HackHype/AlimLigne_PassionIIm/BOM_LignePassionIIm.xlsx

BOM - PCB Bloc de Ligne Passion IIM
Quoi | Variante | Ref PCB | Valeur | Reference | Qty/PCB | Qty/Tot | Prix | PrixTot/PCB | Fabriquant | Fournisseur | Lien | Etat
Borne a Vis |  | J1, J2, J4 | P2.54mm |  | 3 |  |  | 0.00 CHF |  | AliExpress
Borne a Vis |  | J3 | P5.08mm |  | 1 |  |  | 0.00 CHF |  | AliExpress
Resistance Gate FET |  | R14 | 100R 5W |  | 1 |  | 0.15 CHF | 0.15 CHF |  | AliExpress | https://de.aliexpress.com/item/1005005674103930.html
Resistance de Shunt |  | R3 | 1R 2W |  | 1 |  | 0.08 CHF | 0.08 CHF |  | AliExpress | https://de.aliexpress.com/item/1005004002774546.html
Fiche Banane Rouge | Ligne |  |  |  | 1 |  | 0.05 CHF | 0.05 CHF |  | AliExpress | https://de.aliexpress.com/item/1005011562556892.html
Fiche Banane Noir | Ligne |  |  |  | 1 |  | 0.05 CHF | 0.05 CHF |  | AliExpress | https://de.aliexpress.com/item/1005011562556892.html
Fiche Banane Bleu | Ligne |  |  |  | 1 |  | 0.05 CHF | 0.05 CHF |  | AliExpress | https://de.aliexpress.com/item/1005011562556892.html
Fiche Banane Jaune | Ligne |  |  |  | 1 |  | 0.05 CHF | 0.05 CHF |  | AliExpress | https://de.aliexpress.com/item/1005011562556892.html
Interrupteur | Ligne |  | 3 pos 3 cont |  | 1 |  | 1.52 CHF | 1.52 CHF |  | AliExpress | https://de.aliexpress.com/item/1005012410174447.html
Bouton poussoir |  |  |  |  | 2 |  | 0.43 CHF | 0.86 CHF |  | AliExpress | https://de.aliexpress.com/item/1005008777027854.html
Led |  |  | vertes |  | 2 |  | 0.05 CHF | 0.10 CHF |  | AliExpress
Led |  |  | jaunes |  | 2 |  | 0.05 CHF | 0.10 CHF |  | AliExpress
Dissipateur termique |  |  |  |  | 1 |  | 0.15 CHF | 0.15 CHF |  | AliExpress | https://de.aliexpress.com/item/32676786935.html
Relai BiStable de Puissance | Toutes | K1 |  | 41.52.6.012.4016 | 1 |  | 5.50 CHF | 5.50 CHF | Finder | Conrad | https://www.conrad.ch/fr/p/finder-41-52-6-012-4016-relais-pour-circuits-imprimes-12-v-dc-8-a-2-inverseurs-rt-1-pc-s-1419696.html
Transistor |  | Q1 |  | IRFU5305PBF | 1 |  | 0.42 CHF | 0.42 CHF | Infineon Technologie | Conrad | https://www.conrad.ch/fr/p/infineon-technologies-irfu5305pbf-mosfet-1-canal-p-110-w-i-pak-162729.html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
Connecteur DIN |  |  |  |  | 2 |  | 2.45 CHF | 4.90 CHF |  | Conrad | https://www.conrad.ch/de/p/tru-components-tc-13895648-rundsteckverbinder-stecker-buchsenkontakt-gesamtpolzahl-6-serie-rundsteckverbinder-gx16-3473912.html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
Potentiometre |  |  | 4K7 |  | 1 |  | 4.25 CHF | 4.25 CHF |  | Conrad | https://www.conrad.ch/fr/p/potentiometre-rotatif-weltron-wcip20cips-08-60f1-4k7-20-lin-002045038962-avec-interrupteur-mono-0-4-w-4-7-k-1-pc-s-441128.html
555 | Toutes | U1 |  | TLC555CP | 1 |  | 0.68 CHF | 0.68 CHF | TI | Digikey | https://www.digikey.ch/fr/products/detail/texas-instruments/TLC555CP/277502 | Commandé
Transistor | Toutes | Q2, Q3, Q4 |  | 2N2222A | 3 |  | 0.09 CHF | 0.26 CHF | Diotec Semiconductor | Digikey | https://www.digikey.ch/fr/products/detail/diotec-semiconductor/2N2222A/13164037 | Commandé
Mosfet | Toutes | Q6 |  | IRF4905PBF | 1 |  | 2.48 CHF | 2.48 CHF | Infineon Technologie | Digikey | https://www.digikey.ch/fr/products/detail/infineon-technologies/IRF4905PBF/812139 | Commandé
Diode Roue Libr Mosfet | Toutes | D5 |  | MUR420G | 1 |  | 0.51 CHF | 0.51 CHF | Onsemi | Digikey | https://www.digikey.ch/fr/products/detail/onsemi/MUR420G/1482828?s=N4IgTCBcDaILIFUBKAWMAGA4iAugXyA | Commandé
Diode | 2 Arduino 4 Autres | D1, D2, D3, D4 |  | 1N4007 | 4 |  | 0.07 CHF | 0.27 CHF | Diotec Semiconductor | Digikey | https://www.digikey.ch/fr/products/detail/diotec-semiconductor/1N4007/18833652 | Commandé
Diode Zener | Toutes | D6 |  | 1N4733A | 1 |  | 0.23 CHF | 0.23 CHF |  | Digikey | https://www.digikey.ch/fr/products/detail/onsemi/1n4733a/977210 | Commandé
Capuchon pour pot |  |  |  |  | 1 |  | 1.00 CHF | 1.00 CHF |  | Impression 3D
Relai Bistable de Signal | Toutes | K2 |  |  | 1 |  | 0.50 CHF | 0.50 CHF |  | Stock
Condensateur |  | C3 | 100nF |  | 1 |  | 0.05 CHF | 0.05 CHF |  | Stock
Condensateur |  | C4 | 1nF |  | 1 |  | 0.05 CHF | 0.05 CHF |  | Stock
Resistance |  | R8, R10, R13, R14, R19 | 10K |  | 5 |  | 0.05 CHF | 0.25 CHF |  | Stock
Resistance |  | R4, R12, R15 | 1K 1/4W |  | 3 |  | 0.05 CHF | 0.15 CHF |  | Stock
Resistance |  | R7 | 470R 1/4W |  | 1 |  | 0.05 CHF | 0.05 CHF |  | Stock
Resistance |  | R9, R18 | 270R 1/4W |  | 2 |  | 0.05 CHF | 0.10 CHF |  | Stock
Resistance |  | R1, R2, R5, R6 | Pour led |  | 4 |  | 0.05 CHF | 0.20 CHF |  | Stock
Condensateur |  | C1, C2 | ~1000uF |  | 2 |  |  | 0.00 CHF
Condensateur |  | C5 | 270nF |  | 1 |  |  | 0.00 CHF
Date : |  | 2026-04-14 | #VALUE!
Auteur : |  | Jules Grucy
Revision : |  | V2
Approbateur : |  | Damien De P.
