HackHype/AlimLigne_PassionIIm/Repartition_couts.xlsx

Sheet: Offre
 | Pupitre ligne | Régulateur traction | Matériel réserve | Prototype | Sous-total | Total
 | 45 | 35 | 35 | 45
Commun |  |  |  | 1 | 45.00 CHF
Fred | 2 | 4 | 1 |  | 265.00 CHF | 280.00 CHF
Stéphane | 2 | 1 | 1 |  | 160.00 CHF | 175.00 CHF
Raphael | 1 | 1 | 1 |  | 115.00 CHF | 130.00 CHF
 |  |  |  |  |  | 585.00 CHF

Sheet: Compte
Depenses
Digikey | 77.35 CHF
Aliexpress | 100.61 CHF
Conrad 1
Conrad (est) | 230.00 CHF
stock (est) | 21.00 CHF
PCB (est) | 43.00 CHF
3D (est) | 66.00 CHF
Total | 537.96 CHF
Marge (est) | 47.04 CHF
