HackHype/AlimLigne_PassionIIm/Meca_IIm_Ligne/StandardParts/contrainte.pdf

## Module « Bureau technique » - CAO mécanique

### 1. Contraintes disponibles dans Inventor

Icônes | Contrainte | Description
| Horizontale | Permet de fixer une distance horizontale entre 2 points.
| Verticale | Permet de fixer une distance verticale entre 2 points.
| Perpendiculaire | Contraint 2 lignes à être perpendiculaires l'une par rapport à l'autre.
| Parallèle | Contraint 2 lignes à être parallèles l'une par rapport à l'autre.
| Tangente | Contraint 2 courbes à un point de tangence.
| Symétrique | Force 2 objets à se placer symétriquement l'un par rapport à l'autre.
| Fixe | Permet de fixer un point ou un objet à un emplacement dans le dessin.
| Egal | Force 2 lignes à avoir une longueur identique ou 2 arcs ou cercles au même rayon.
| Concentrique | Permet de placer 2 cercles ou arcs sur le même centre.
| Doux | Permet de contraindre une spline à se positionner dans la continuité d'un objet.
| Colinéaire | Permet de contraindre 2 lignes sur le même axe l'une par rapport à l'autre.
| Coïncidence | Permet de faire coïncider un point par rapport à un autre point ou objet.

## Module « Bureau technique » - CAO mécanique

### 1. Contraintes disponibles dans Inventor

Icônes | Contrainte | Description
| Horizontale | Permet de fixer une distance horizontale entre 2 points.
| Verticale | Permet de fixer une distance verticale entre 2 points.
| Perpendiculaire | Contraint 2 lignes à être perpendiculaires l'une par rapport à l'autre.
| Parallèle | Contraint 2 lignes à être parallèles l'une par rapport à l'autre.
| Tangente | Contraint 2 courbes à un point de tangence.
| Symétrique | Force 2 objets à se placer symétriquement l'un par rapport à l'autre.
| Fixe | Permet de fixer un point ou un objet à un emplacement dans le dessin.
| Egal | Force 2 lignes à avoir une longueur identique ou 2 arcs ou cercles au même rayon.
| Concentrique | Permet de placer 2 cercles ou arcs sur le même centre.
| Doux | Permet de contraindre une spline à se positionner dans la continuité d'un objet.
| Colinéaire | Permet de contraindre 2 lignes sur le même axe l'une par rapport à l'autre.
| Coïncidence | Permet de faire coïncider un point par rapport à un autre point ou objet.
