HackHype/AlimLigne_PassionIIm/3D/to92-7.snapshot.5/TO92.STEP

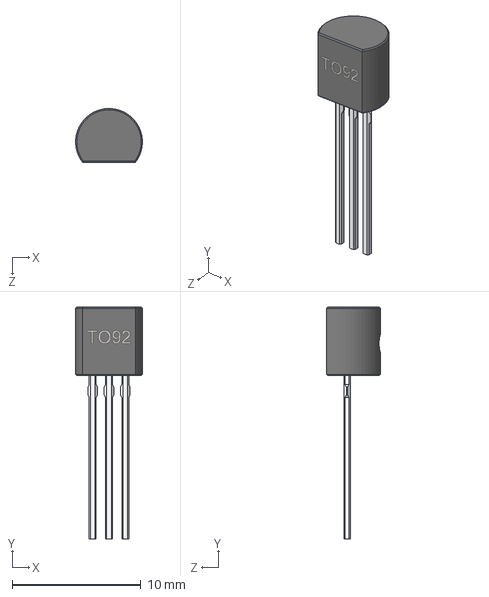
[picture p1: CAD file, 2026-05-08]
3D/to92-7.snapshot.5/TO92.STEP
5.20 x 18.0 x 4.20 mm
