HackHype/AlimLigne_PassionIIm/3D/to92-7.snapshot.5/TO92_2.STEP

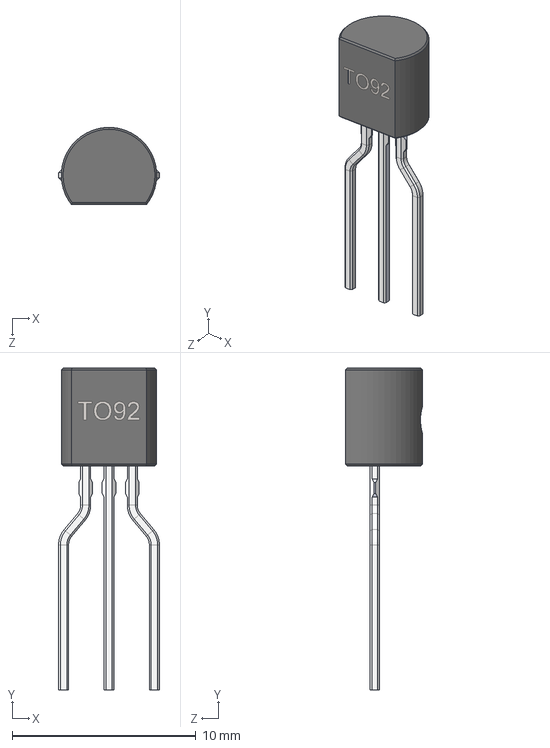
[picture p3: CAD file, 2026-05-08]
3D/to92-7.snapshot.5/TO92_2.STEP
5.49 x 17.5 x 4.20 mm
