HackHype/AlimLigne_PassionIIm/Meca_IIm_Ligne/Couvercle_Meca_IIm_Ligne.obj

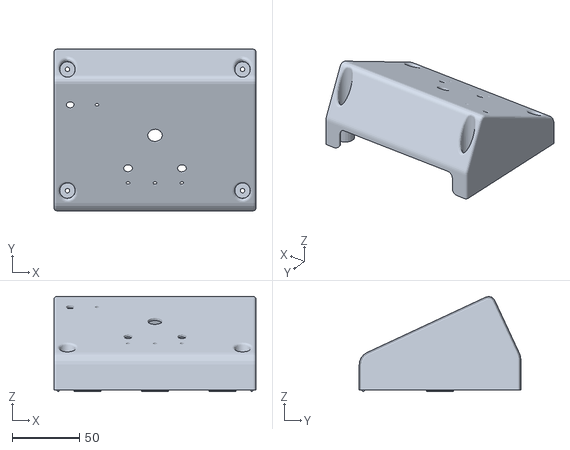
[picture p4: CAD file, 2026-09-28]
Meca_IIm_Ligne/Couvercle_Meca_IIm_Ligne.obj
150.0 x 120.0 x 70.6
