HackHype/AlimLigne_PassionIIm/Meca_IIm_Ligne/Leste_Meca_IIm_Ligne.obj

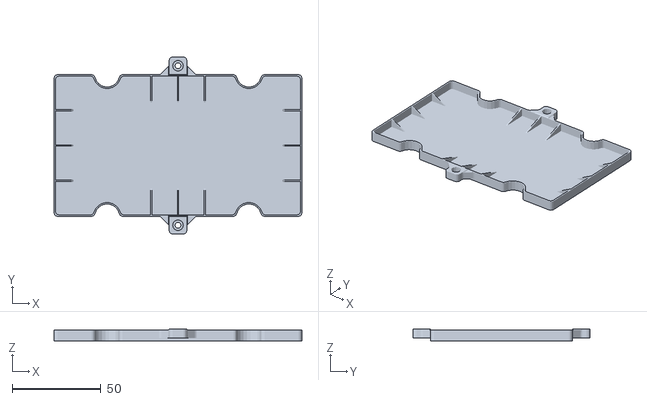
[picture p5: CAD file, 2026-09-06]
Meca_IIm_Ligne/Leste_Meca_IIm_Ligne.obj
140.0 x 100.0 x 6.50
