HackHype/AlimLigne_PassionIIm/(list of files, cad)

Other CAD files:
3D/to92-7.snapshot.5/TO92.x_t
3D/to92-7.snapshot.5/TO92_2.x_t
Meca_IIm_Ligne/Base_Meca_IIm_Ligne.ipt
Meca_IIm_Ligne/Couvercle_Meca_IIm_Ligne.ipt
Meca_IIm_Ligne/E1_Base_Meca_IIm_Ligne.iam
Meca_IIm_Ligne/Leste_Meca_IIm_Ligne.ipt
Meca_IIm_Ligne/OldVersions/Base_Meca_IIm_Ligne.0007.ipt
Meca_IIm_Ligne/OldVersions/Couvercle_Meca_IIm_Ligne.0010.ipt
Meca_IIm_Ligne/OldVersions/E1_Base_Meca_IIm_Ligne.0008.iam
Meca_IIm_Ligne/OldVersions/Leste_Meca_IIm_Ligne.0005.ipt
Meca_IIm_Ligne/StandardParts/Etau/P2305_004_Vis.ipt
Meca_IIm_Ligne/StandardParts/Etau/P2305_005_Ecrou.ipt
Meca_IIm_Ligne/StandardParts/Item/Item_0037001_Ecrou_M5.ipt
Meca_IIm_Ligne/StandardParts/Item/Item_0037006_Ecrou_M4.ipt
Meca_IIm_Ligne/StandardParts/Item/Item_0043719_Ecrou_M3.ipt
Meca_IIm_Ligne/StandardParts/Item/item_0037003_Profil_5_20x20.ipt
Meca_IIm_Ligne/StandardParts/Visserie/BN1075_RondellePolyamide.ipt
Meca_IIm_Ligne/StandardParts/Visserie/BN1976_RondelleAjustage.ipt
Meca_IIm_Ligne/StandardParts/Visserie/BN425_GoujonFilete.ipt
Meca_IIm_Ligne/StandardParts/Visserie/BN5281_DouilleEcartement.ipt
Meca_IIm_Ligne/StandardParts/Visserie/BN7372_EntretoiseHexagonale.ipt
Meca_IIm_Ligne/StandardParts/Visserie/ISO14581.ipt
Meca_IIm_Ligne/StandardParts/Visserie/ISO4032_Ecrou.ipt
Meca_IIm_Ligne/StandardParts/Visserie/ISO4032_Ecrou/ISO4032_M3.ipt
Meca_IIm_Ligne/StandardParts/Visserie/ISO4762.ipt
Meca_IIm_Ligne/StandardParts/Visserie/ISO4762/ISO4762_M3x10.ipt
Meca_IIm_Ligne/StandardParts/Visserie/ISO4762/ISO4762_M3x5.ipt
Meca_IIm_Ligne/StandardParts/Visserie/ISO7089_Rondelle.ipt
Meca_IIm_Ligne/StandardParts/Visserie/SN213912.ipt
