HackHype/AlimLigne_PassionIIm/Meca_IIm_Ligne/StandardParts/Scotch/P1305_001_Axe.pdf

28

(4) 20

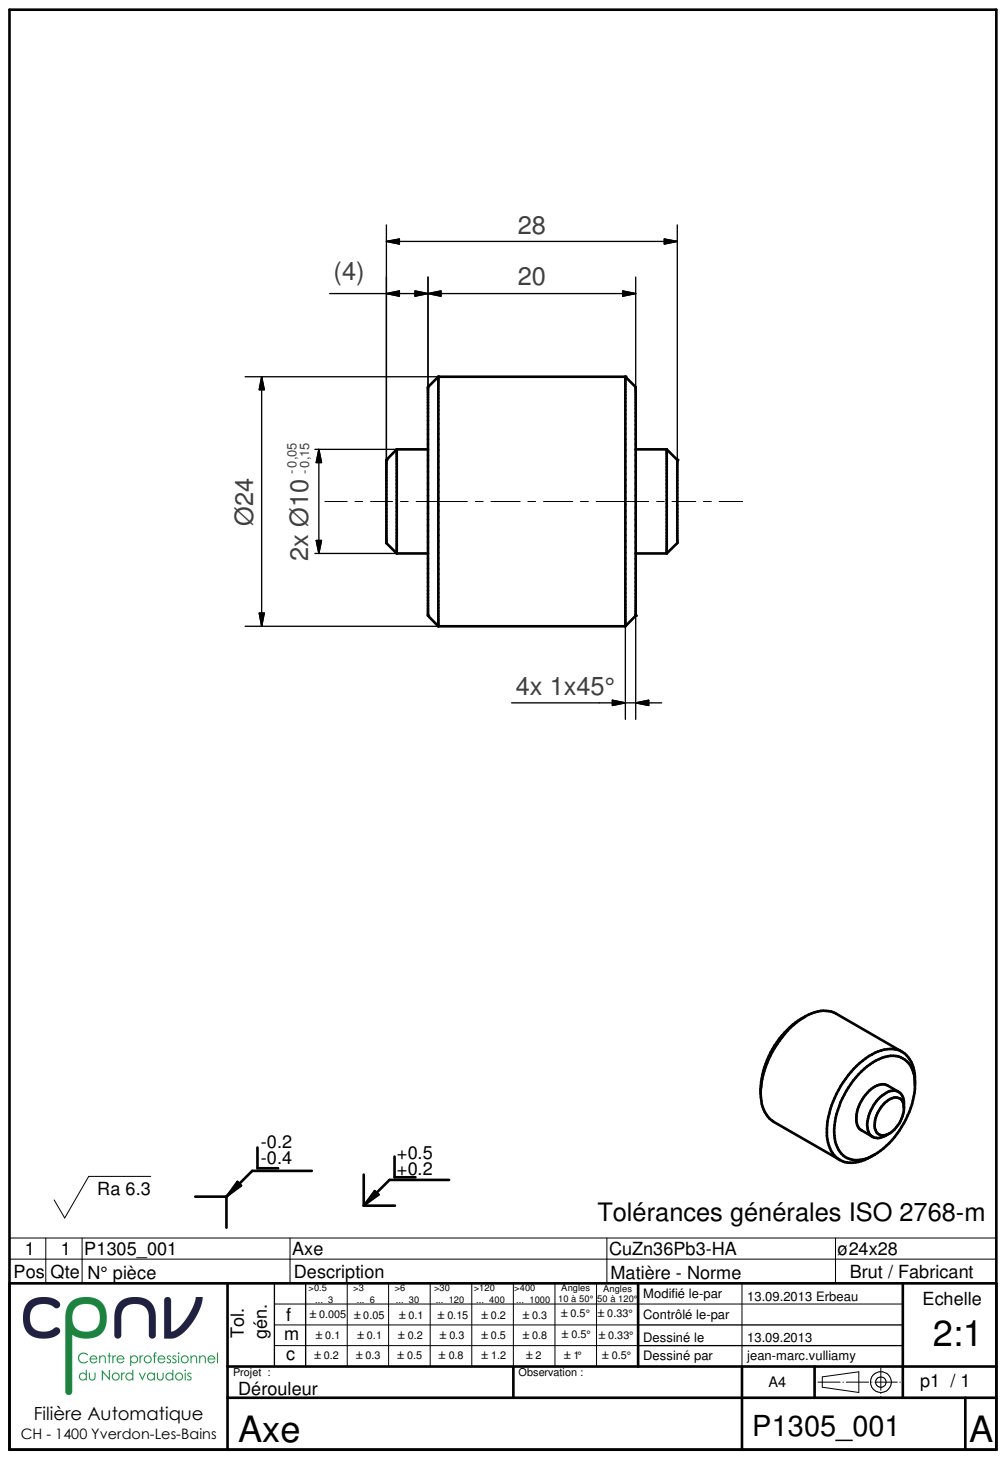
[picture p6: page 1]
gén.

Tolérances générales ISO 2768-m

1 | 1 | P1305_001 | Axe | CuZn36Pb3-HA | ø24x28
Pos | Qte | N° pièce | Description | Matière - Norme | Brut / Fabricant

Filière Automatique CH - 1400 Yverdon-Les-Bains | | | >0.5 ... 3 | >3 ... 6 | >6 ... 30 | >30 ... 120 | >120 ... 400 | >400 ... 1000 | Angles 10 à 50° | Angles 50 à 120° | Modifié le-par | 13.09.2013 Erbeau | Echelle 2:1

f | `0.005 | `0.05 | `0.1 | `0.15 | `0.2 | `0.3 | `0.5° | `0.33° | Contrôlé le-par
m | `0.1 | `0.1 | `0.2 | `0.3 | `0.5 | `0.8 | `0.5° | `0.33° | Dessiné le | 13.09.2013

c | `0.2 | `0.3 | `0.5 | `0.8 | `1.2 | `2 | `1° | `0.5° | Dessiné par | jean-marc.vulliamy

Projet : Dérouleur | Observation : | A4 | | | | p1 / 1
Axe | P1305_001 | A
