HackHype/AlimLigne_PassionIIm/Meca_IIm_Ligne/StandardParts/Scotch/P1305_004_couteau.pdf

A-A ( 2 : 1 ) | B ( 4 : 1 ) | C ( 2 : 1 )

2x 6

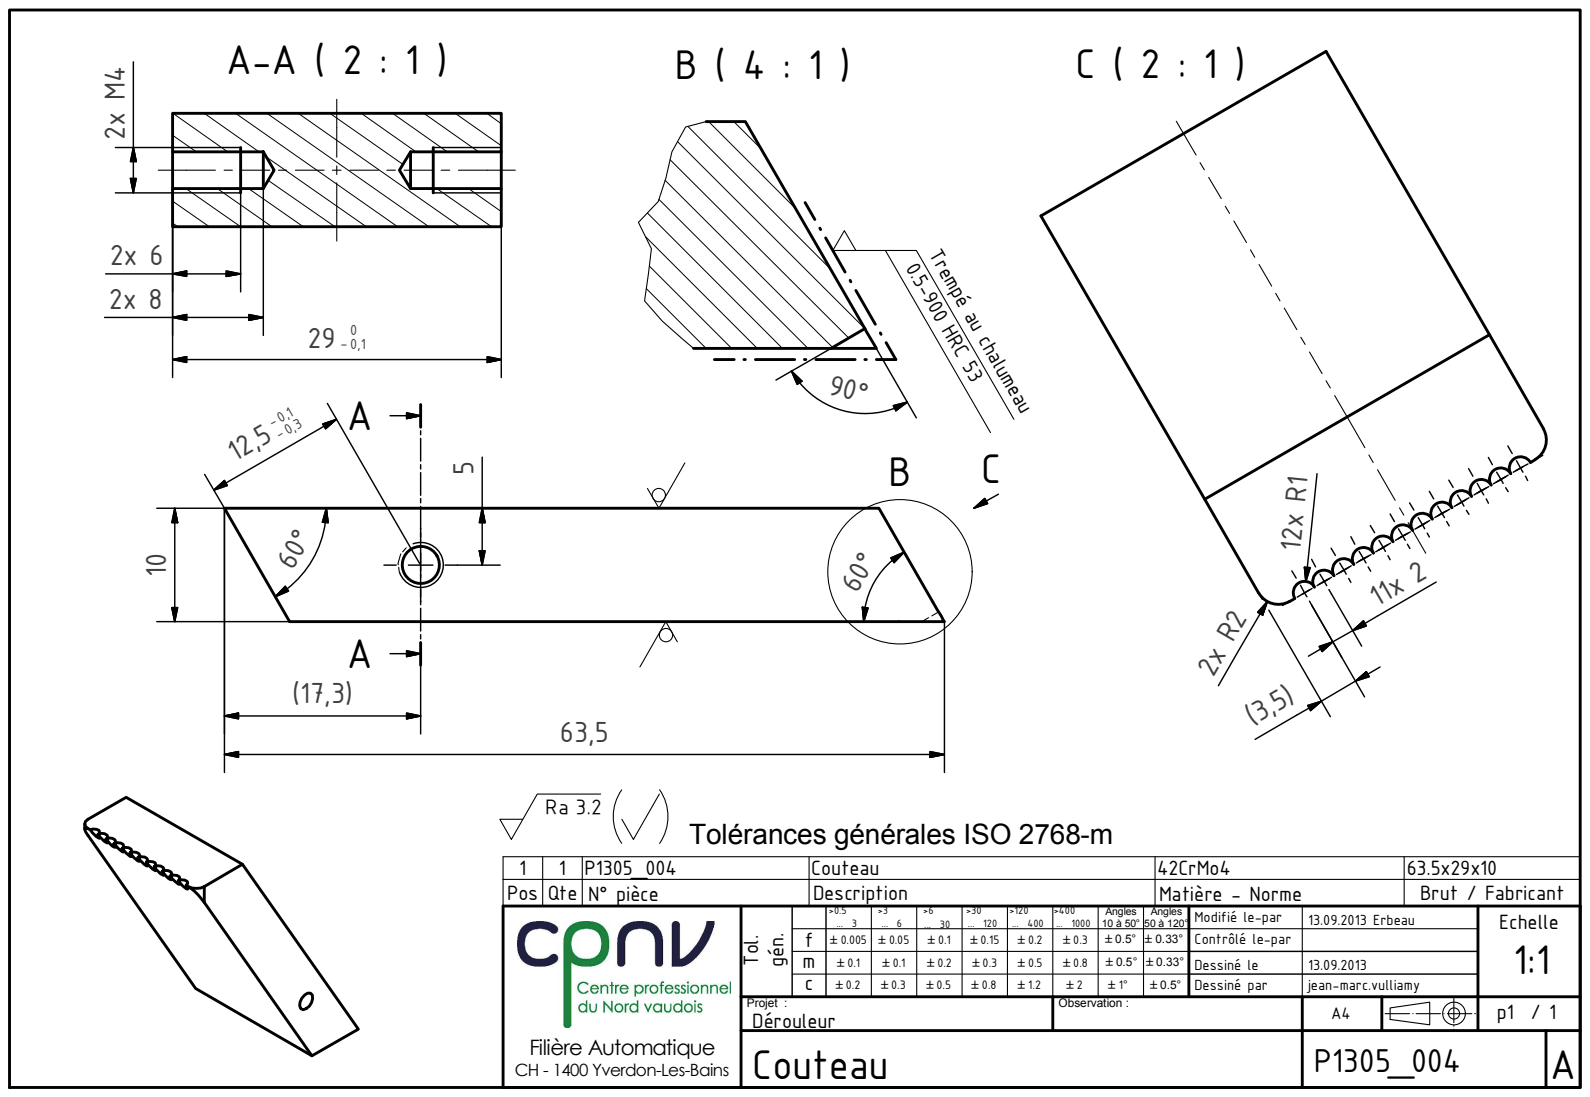
[picture p7: page 1]
Couteau; 42CrMo4; Pos; Qte; Description; Matire - Norme; Brut / Fabricant; Tol.; Angles; Echelle; Dessin par; Observation :; Drouleur; Projet :; Modifi le-par; 13.09.2013 Erbeau; Angles 10 j 50°; Tremp; au chalumeau; HRC

Tolprances gpnprales ISO 2768-m

f | B0.005 | B0.05 | B0.1 | B0.15 | B0.2 | B0.3 | B0.5° | B0.33° | Contr§l le-par

m | B0.1 | B0.1 | B0.2 | B0.3 | B0.5 | B0.8 | B0.5° | B0.33° | Dessin le

jean-marc.vulliamy

Filiqre Automatique
CH - 1400 Yverdon-Les-Bains
