HackHype/AlimLigne_PassionIIm/Meca_IIm_Ligne/StandardParts/Scotch/P1305_EG_Derouleur.pdf

5 | 1 | 2

3

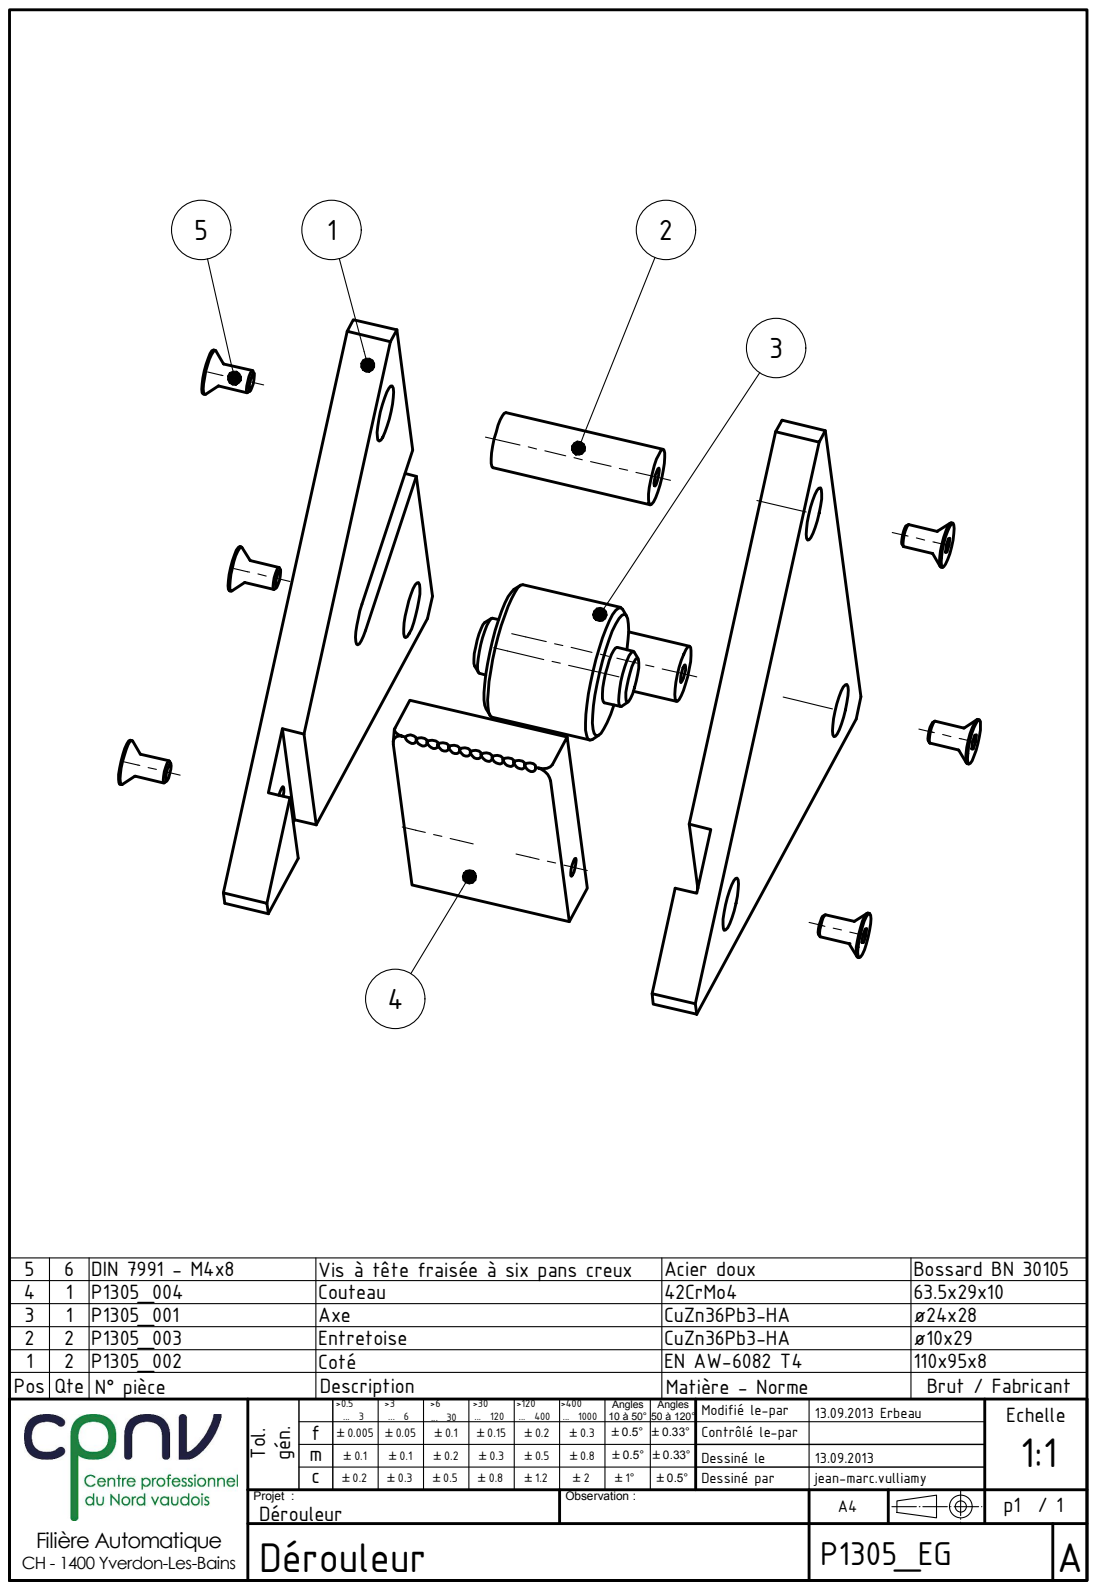
[picture p8: page 1]
DIN 7991 - M4x8; Vis  tte fraise  six pans creux; Acier doux; Bossard BN 30105; Couteau; 42CrMo4; Axe; CuZn36Pb3-HA; Entretoise; Cot; Pos; Qte; Description; Matire - Norme; Brut / Fabricant; Tol.; Angles; Echelle; Dessin par; Observation :; Drouleur; Projet :; Modifi le-par; 13.09.2013 Erbeau; Angles 10 j 50°

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

jean-marc.vulliamy

Filiqre Automatique
CH - 1400 Yverdon-Les-Bains
