HackHype/AlimLigne_PassionIIm/555.asc

D1: diode
D2: diode
R1: res
R2: res
U1: NE555
V1: voltage
Named nets: 0, V_CC
