HackHype/AlimLigne_PassionIIm/PCB_IIm_Ligne.kicad_sch

## KiCad design PCB_IIm_Ligne.kicad_sch (2026-10-16, an earlier design)

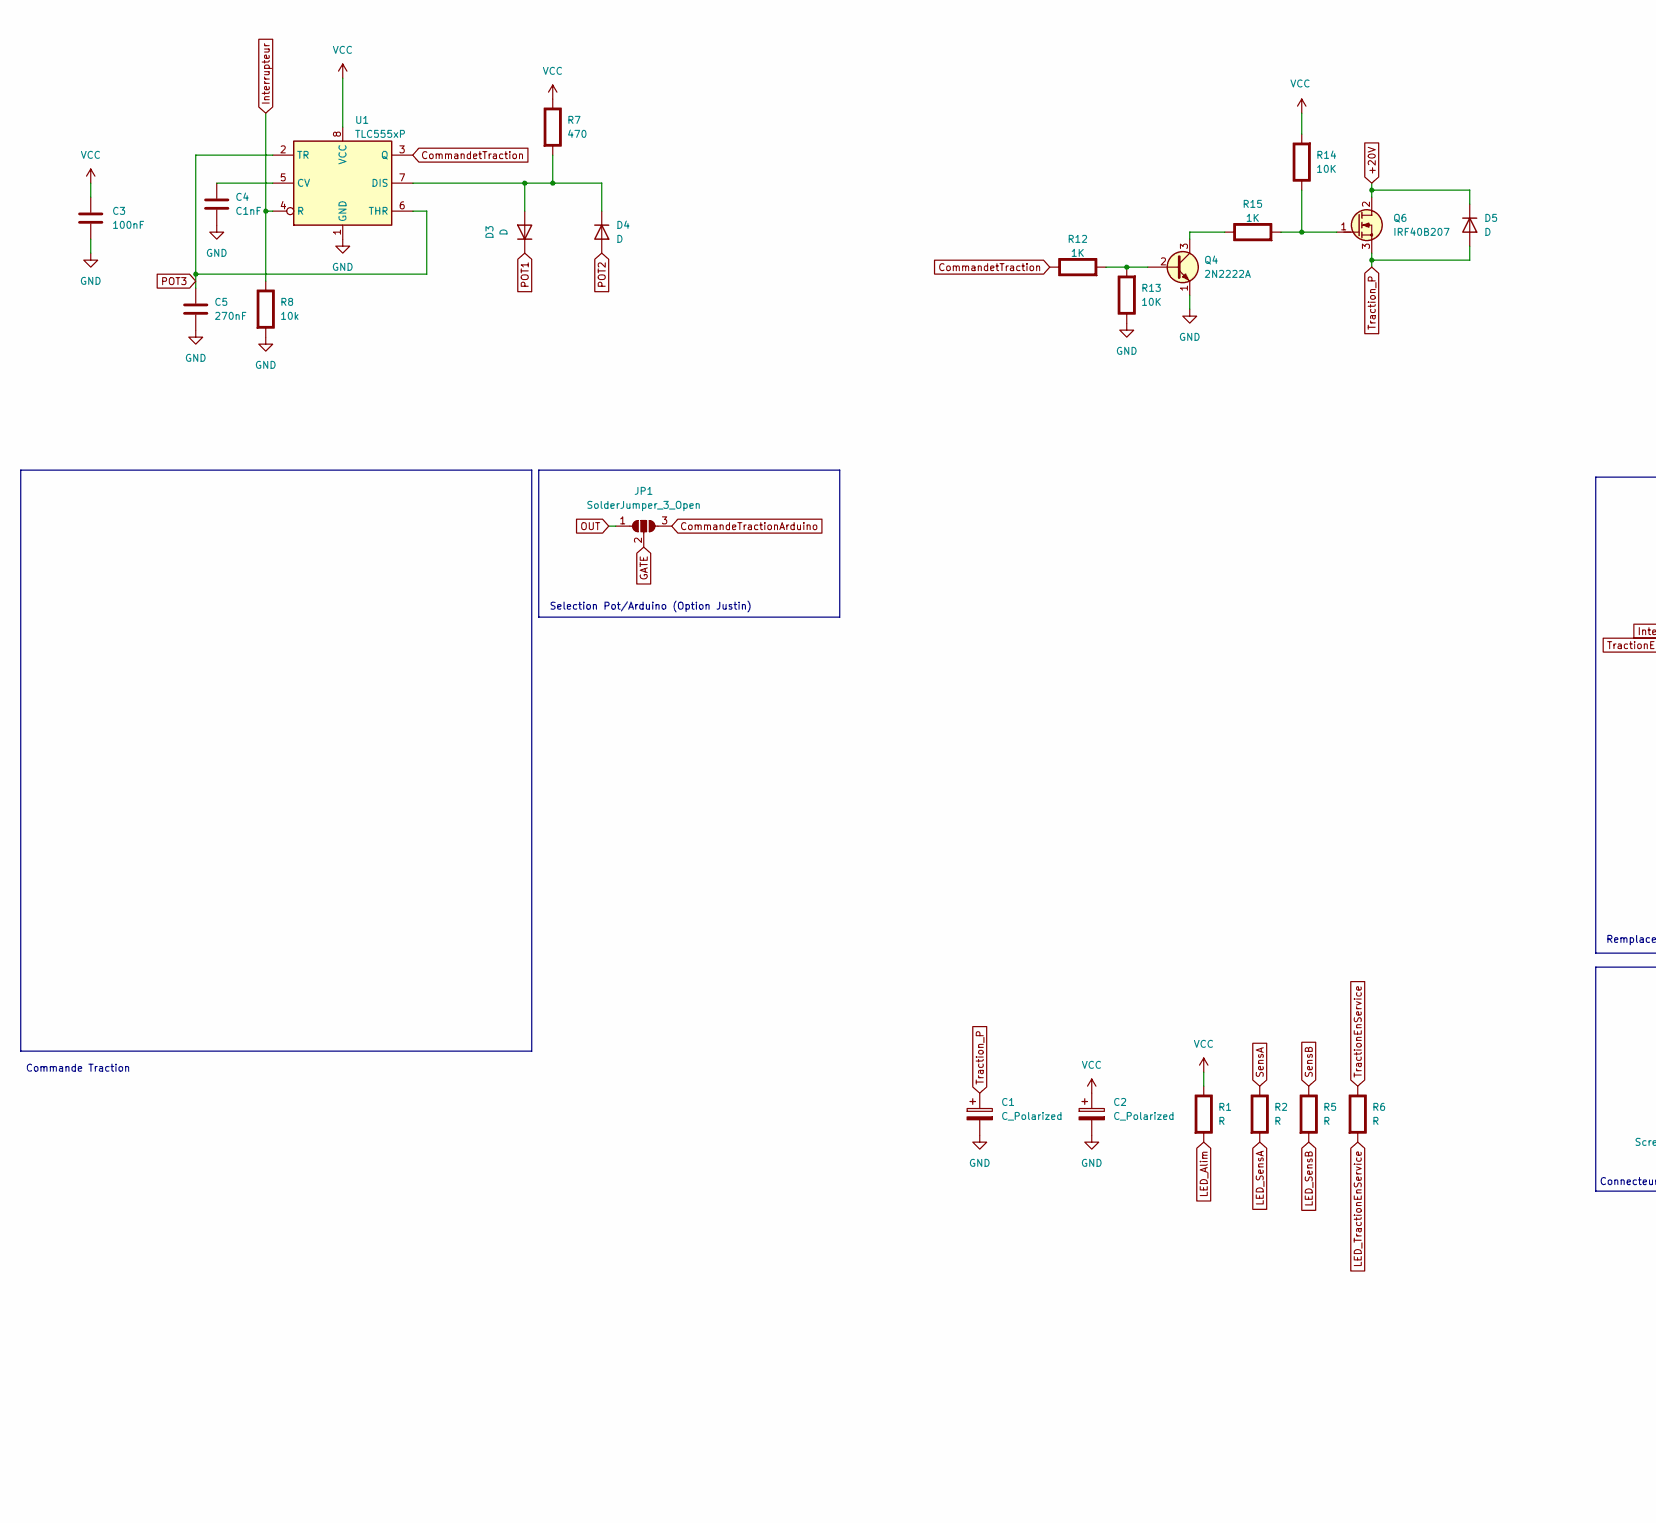
[picture p9: schematic PCB_IIm_Ligne.kicad_sch, part in row 1, column 1]

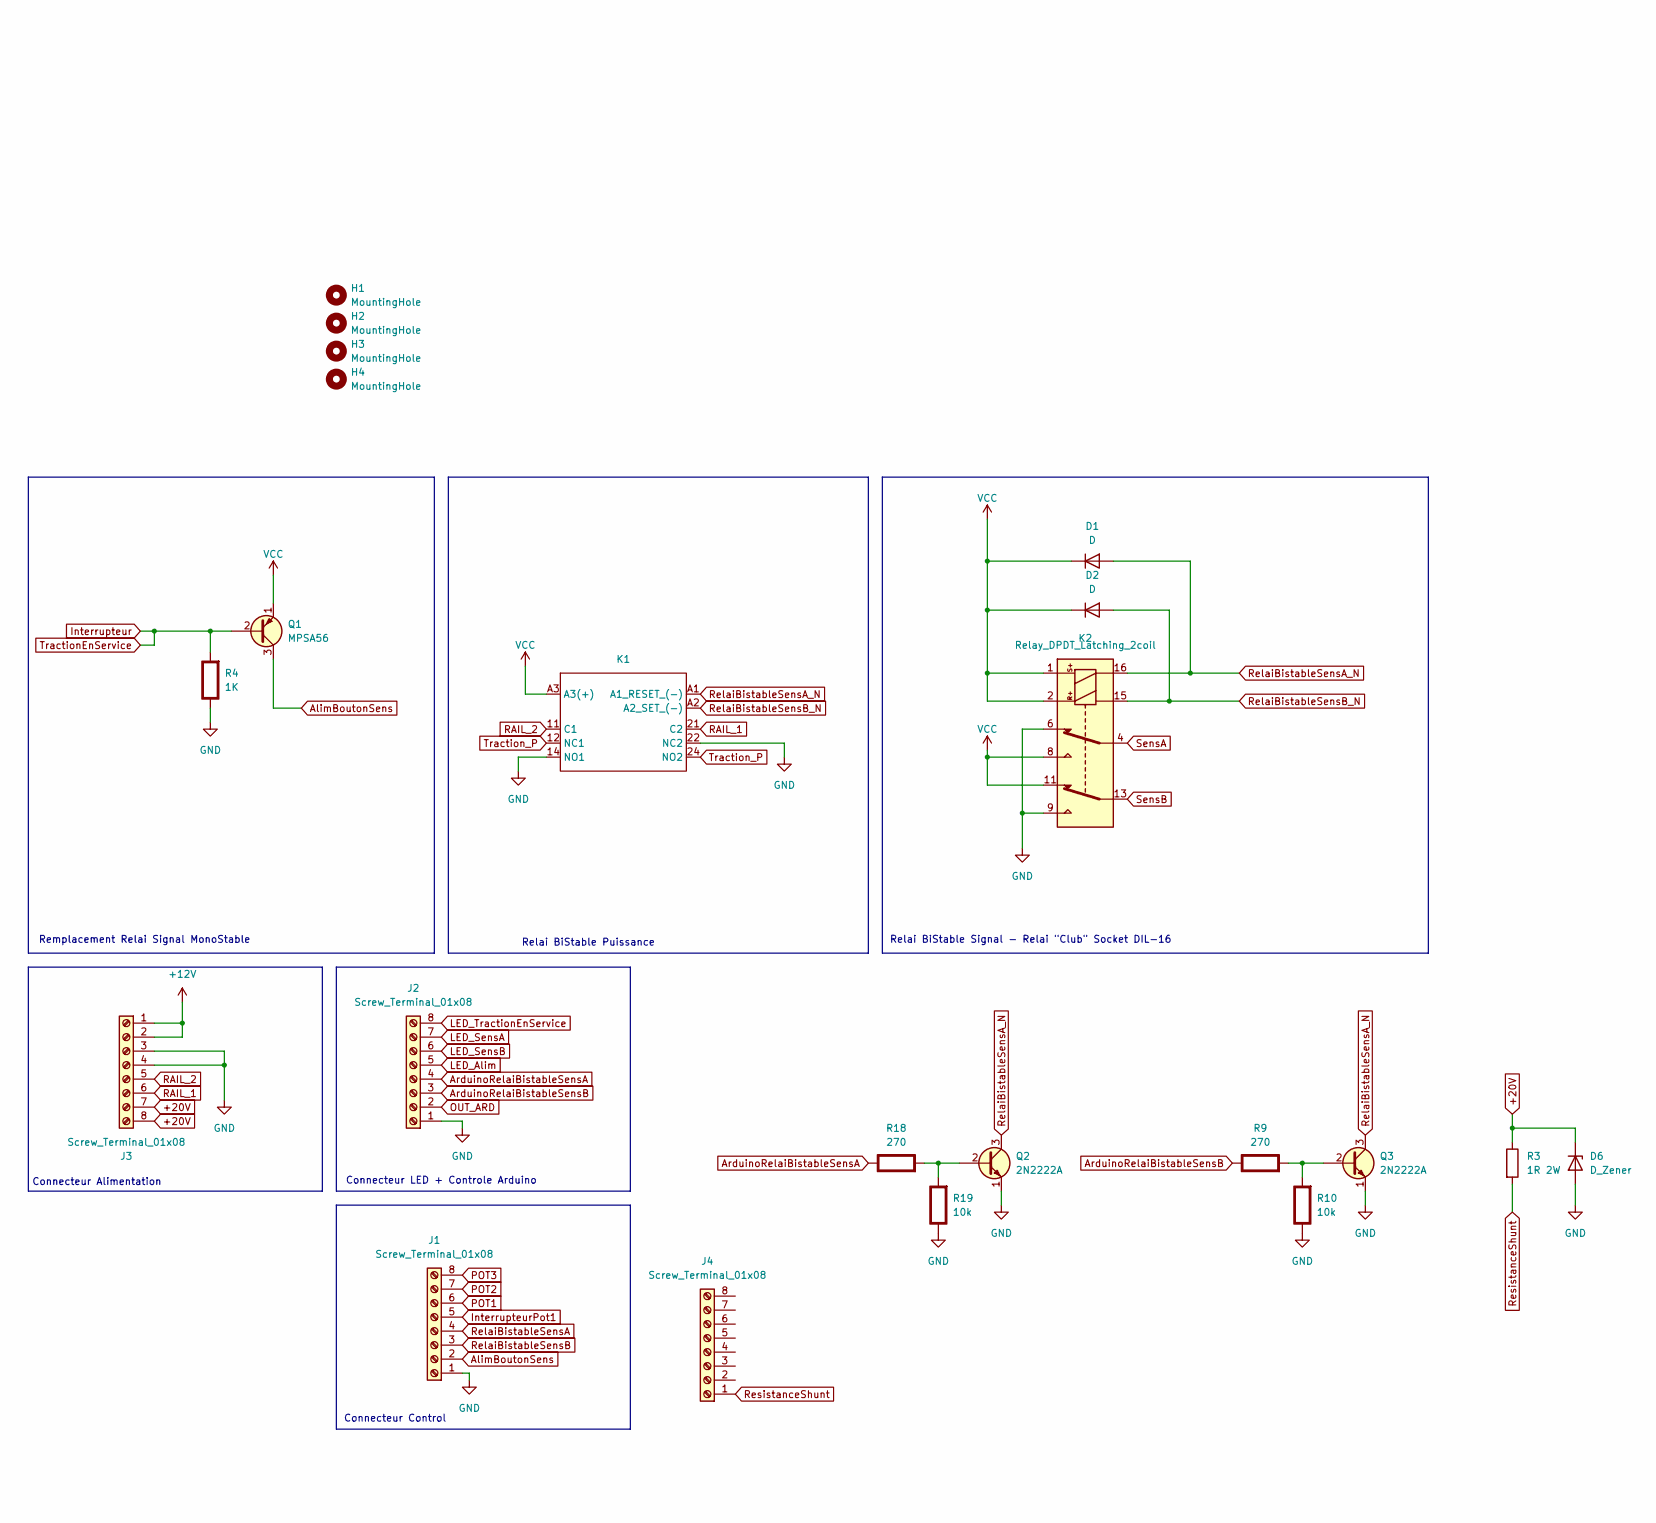
[picture p10: schematic PCB_IIm_Ligne.kicad_sch, part in row 1, column 2]

Parts:
C1, C2: C_Polarized
C3: 100nF; C_Rect_L7.5mm_W6.5mm_P5.00mm
C4: C1nF; C_Rect_L7.5mm_W6.5mm_P5.00mm
C5: 270nF; C_Rect_L7.5mm_W6.5mm_P5.00mm
D1, D2, D3, D4, D5: D; D_DO-15_P10.16mm_Horizontal
D6: D_Zener; D_DO-15_P10.16mm_Horizontal
H1, H2, H3, H4: MountingHole; MountingHole_3.2mm_M3
J1, J2, J4: Screw_Terminal_01x08; TerminalBlock_Phoenix_MPT-0,5-8-2.54_1x08_P2.54mm_Horizontal
J3: Screw_Terminal_01x08; TerminalBlock_Phoenix_MKDS-1,5-8-5.08_1x08_P5.08mm_Horizont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
JP1: SolderJumper_3_Open; SolderJumper-3_P1.3mm_Open_RoundedPad1.0x1.5mm
K1: Finder_41.52.6.012.4016
K2: Relay_DPDT_Latching_2coil; DIP-16_W10.16mm_LongPads
Q1: MPSA56; TO-92_Inline_Wide_EBC
Q2, Q3, Q4: 2N2222A; TO-92_Inline_Wide_EBC
Q6: IRF40B207; TO-220-3_Vertical_GDS
R1, R2, R5, R6: R; R_Axial_DIN0207_L6.3mm_D2.5mm_P10.16mm_Horizontal; Rating W
R3: 1R 2W; R_Axial_DIN0411_L9.9mm_D3.6mm_P12.70mm_Horizontal
R4, R12, R15: 1K; R_Axial_DIN0207_L6.3mm_D2.5mm_P10.16mm_Horizontal; Rating W
R7: 470; R_Axial_DIN0207_L6.3mm_D2.5mm_P10.16mm_Horizontal; Rating W
R8, R10, R19: 10k; R_Axial_DIN0207_L6.3mm_D2.5mm_P10.16mm_Horizontal; Rating W
R9, R18: 270; R_Axial_DIN0207_L6.3mm_D2.5mm_P10.16mm_Horizontal; Rating W
R13, R14: 10K; R_Axial_DIN0207_L6.3mm_D2.5mm_P10.16mm_Horizontal; Rating W
U1: TLC555xP; DIP-8_W7.62mm_LongPads

Connections:
+12V: J3.1, J3.2
+20V: D5.1 (K), D6.1 (K), J3.7, J3.8, Q6.2 (D), R3.1
AlimBoutonSens: J1.2, Q1.3 (C)
ArduinoRelaiBistableSensA: J2.4, R18.1 (+)
ArduinoRelaiBistableSensB: J2.3, R9.1 (+)
CommandeTractionArduino: JP1.3 (B)
CommandetTraction: R12.1 (+), U1.3 (Q)
GATE: JP1.2 (C)
GND: C1.2, C2.2, C3.2, C4.2, C5.2, D6.2 (A), J1.1, J2.1, J3.3, J3.4, K1.14 (NO1), K1.22 (NC2), K2.6, K2.9, Q2.1 (E), Q3.1 (E), Q4.1 (E), R4.1 (+), R8.2 (-), R10.1 (+), R13.1 (+), R19.1 (+), U1.1 (GND)
Interrupteur: Q1.2 (B), R4.2 (-), R6.1 (+), R8.1 (+), U1.4 (R)
InterrupteurPot1: J1.5
LED_Alim: J2.5, R1.2 (-)
LED_SensA: J2.7, R2.2 (-)
LED_SensB: J2.6, R5.2 (-)
LED_TractionEnService: J2.8, R6.2 (-)
unnamed: C4.1, U1.5 (CV)
unnamed: D3.2 (A), D4.1 (K), R7.2 (-), U1.7 (DIS)
unnamed: Q2.2 (B), R18.2 (-), R19.2 (-)
unnamed: Q3.2 (B), R9.2 (-), R10.2 (-)
unnamed: Q4.2 (B), R12.2 (-), R13.2 (-)
unnamed: Q4.3 (C), R15.1 (+)
unnamed: Q6.1 (G), R14.1 (+), R15.2 (-)
OUT: JP1.1 (A)
OUT_ARD: J2.2
POT1: D3.1 (K), J1.6
POT2: D4.2 (A), J1.7
POT3: C5.1, J1.8, U1.2 (TR), U1.6 (THR)
RAIL_1: J3.6, K1.21 (C2)
RAIL_2: J3.5, K1.11 (C1)
RelaiBistableSensA: J1.4
RelaiBistableSensA_N: D1.2 (A), K1.A1 (A1_RESET_(-)), K2.16, Q2.3 (C), Q3.3 (C)
RelaiBistableSensB: J1.3
RelaiBistableSensB_N: D2.2 (A), K1.A2 (A2_SET_(-)), K2.15
ResistanceShunt: J4.1, R3.2
SensA: K2.4, R2.1 (+)
SensB: K2.13, R5.1 (+)
Traction_P: C1.1, D5.2 (A), K1.12 (NC1), K1.24 (NO2), Q6.3 (S)
VCC: C2.1, C3.1, D1.1 (K), D2.1 (K), K1.A3 (A3(+)), K2.1, K2.2, K2.8, K2.11, Q1.1 (E), R1.1 (+), R7.1 (+), R14.2 (-), U1.8 (VCC)

Notes on the sheet:
Relai BiStable Signal - Relai "Club" Socket DIL-16
Commande Traction
Selection Pot/Arduino (Option Justin)
Connecteur LED + Controle Arduino
Connecteur Control
Remplacement Relai Signal MonoStable
Relai BiStable Puissance
Connecteur Alimentation
