HackHype/AlimLigne_PassionIIm/TODO.md

TODO
====

# Test
- Changer fréquence pour 10kHz

# Pour commande PCB
- Réordonné les bornes sur les connecteurs
- Séparer interrupteur pot et led "traction en service" pour la version gare
- Vérifier toutes les étiquettes
- Dessiner le PCB
