HackHype/AlimLigne_PassionIIm/(commit log)

2026-04-13 Schematic V1
    [PCB_IIm_Ligne.kicad_pcb, PCB_IIm_Ligne.kicad_sch]
2026-04-14 Schematic V2 + BOM
    [BOM_LignePassionIIm.xlsx, PCB_IIm_Ligne.kicad_pcb, PCB_IIm_Ligne.kicad_sch]
2026-05-08 Schematic V2
    [PCB_IIm_Ligne.kicad_pcb, PCB_IIm_Ligne.kicad_sch, TO92.STEP, TO92.x_t, TO92_2.STEP, TO92_2.x_t]
2026-05-21 Schematic Modification
    [PCB_IIm_Ligne.kicad_sch]
2026-06-23 check BOM
    [BOM_LignePassionIIm.xlsx, PCB_IIm_Ligne.kicad_sch]
2026-08-11 BOM update, new relay + new P side mosfet + Aliexpress links and price
    [BOM_LignePassionIIm.xlsx, P2603_PCBcard.kicad_pcb, P2603_PCBcard.kicad_sch, PCB_IIm_Ligne.kicad_sch]
2026-08-18 minor BOM modif
    [BOM_LignePassionIIm.xlsx]
2026-08-19 Finder relay Lib
    [PCB_IIm_Ligne.kicad_pcb, PCB_IIm_Ligne.kicad_sch]
2026-08-19 Modif Schematic + Layout
    [PCB_IIm_Ligne.kicad_pcb, PCB_IIm_Ligne.kicad_sch]
2026-08-20 ajout repartition cout
    [Repartition_couts.xlsx]
2026-08-21 kicad modif
    [BOM_LignePassionIIm.xlsx, PCB_IIm_Ligne.kicad_pcb, PCB_IIm_Ligne.kicad_sch]
2026-08-21 meca + menage
    [P2603_PCBcard.kicad_pcb, P2603_PCBcard.kicad_sch]
2026-08-27 mecanical Work
    [BN1075_RondellePolyamide.ipt, BN1976_RondelleAjustage.ipt, BN425_GoujonFilete.ipt, BN5281_DouilleEcartement.ipt, BN7372_EntretoiseHexagonale.ipt, BOM_LignePassionIIm.xlsx, Base_Meca_IIm_Ligne.0001.ipt, Base_Meca_IIm_Ligne.ipt]
2026-08-27 meca work
    [E1_Base_Meca_IIm_Ligne.0001.iam, E1_Base_Meca_IIm_Ligne.0002.iam, E1_Base_Meca_IIm_Ligne.iam, Leste_Meca_IIm_Ligne.0002.ipt, Leste_Meca_IIm_Ligne.0004.ipt, Leste_Meca_IIm_Ligne.ipt]
2026-09-06 commande Digikey
    [BOM_LignePassionIIm.xlsx]
2026-09-07 commande Aliexpress
    [BOM_LignePassionIIm.xlsx, Repartition_couts.xlsx]
2026-09-08 compte commande Aliexpress
    [BOM_LignePassionIIm.xlsx, Repartition_couts.xlsx]
2026-09-14 Modification CAD Ajout fixation capot
    [BOM_LignePassionIIm.xlsx, Base_Meca_IIm_Ligne.0003.ipt, Base_Meca_IIm_Ligne.0005.ipt, Base_Meca_IIm_Ligne.ipt, Base_Meca_IIm_Ligne.obj, Couvercle_Meca_IIm_Ligne.0002.ipt, Couvercle_Meca_IIm_Ligne.0003.ipt, Couvercle_Meca_IIm_Ligne.ipt]
2026-09-16 modification front pannel CAD model
    [Couvercle_Meca_IIm_Ligne.0003.ipt, Couvercle_Meca_IIm_Ligne.0005.ipt, Couvercle_Meca_IIm_Ligne.ipt]
2026-09-16 Kicad Modification
    [E1_Base_Meca_IIm_Ligne.0005.iam, E1_Base_Meca_IIm_Ligne.0006.iam, E1_Base_Meca_IIm_Ligne.iam, PCB_IIm_Ligne.kicad_pcb]
2026-09-17 Kicad Schematic organisation
    [PCB_IIm_Ligne.kicad_sch]
2026-09-24 Reorganisation Etiquette et schematic
    [PCB_IIm_Ligne.kicad_sch]
2026-09-24 creatio des trous face avant
    [Couvercle_Meca_IIm_Ligne.0005.ipt, Couvercle_Meca_IIm_Ligne.0007.ipt, Couvercle_Meca_IIm_Ligne.ipt]
2026-09-27 Ajustement taille trou face avant et base
    [BOM_LignePassionIIm.xlsx, Base_Meca_IIm_Ligne.0005.ipt, Base_Meca_IIm_Ligne.0006.ipt, Base_Meca_IIm_Ligne.ipt, Couvercle_Meca_IIm_Ligne.0007.ipt, Couvercle_Meca_IIm_Ligne.0009.ipt, Couvercle_Meca_IIm_Ligne.ipt, Couvercle_Meca_IIm_Ligne.obj]
2026-09-28 Modification taille + position trou front pannel + trou connecteur DIN base + renfort mur
    [Base_Meca_IIm_Ligne.0006.ipt, Base_Meca_IIm_Ligne.0007.ipt, Base_Meca_IIm_Ligne.ipt, Base_Meca_IIm_Ligne.obj, Couvercle_Meca_IIm_Ligne.0009.ipt, Couvercle_Meca_IIm_Ligne.0010.ipt, Couvercle_Meca_IIm_Ligne.ipt, Couvercle_Meca_IIm_Ligne.obj]
2026-10-06 modification taille trou vis
    [Couvercle_Meca_IIm_Ligne.0010.ipt, Couvercle_Meca_IIm_Ligne.0011.ipt, Couvercle_Meca_IIm_Ligne.ipt, E1_Base_Meca_IIm_Ligne.0008.iam, E1_Base_Meca_IIm_Ligne.0009.iam, E1_Base_Meca_IIm_Ligne.iam]
2026-10-16 Resistance de Shunt fix
2026-10-16 resistance shunt
